DVLASZ/Proyecto-Comfort-Termico/(commit log)

2025-10-14 Version final proyecto arduino
    Versión final del proyecto de confort térmico con documentación Doxygen
2025-10-16 Subida Informe Proyecto Arduino
